TobiasLozano/ems-visualization/resultados/15W/datos_15W.xlsx

Sheet: volt_panel
id | timestamp | value
77311 | 2026-05-26 17:21 | 15.551
77312 | 2026-05-26 17:21 | 10.894
77313 | 2026-05-26 17:21 | 13.416
77314 | 2026-05-26 17:21 | 13.713
77315 | 2026-05-26 17:21 | 14.03
77316 | 2026-05-26 17:21 | 14.35
77317 | 2026-05-26 17:21 | 14.683
77318 | 2026-05-26 17:21 | 15.031
77319 | 2026-05-26 17:21 | 15.404
77320 | 2026-05-26 17:21 | 15.629
77321 | 2026-05-26 17:21 | 15.623
77322 | 2026-05-26 17:21 | 15.623
77323 | 2026-05-26 17:21 | 15.62
77324 | 2026-05-26 17:21 | 10.878
77325 | 2026-05-26 17:21 | 10.884
77326 | 2026-05-26 17:22 | 13.465
77327 | 2026-05-26 17:22 | 13.764
77328 | 2026-05-26 17:22 | 14.073
77329 | 2026-05-26 17:22 | 14.406
77330 | 2026-05-26 17:22 | 14.743
77331 | 2026-05-26 17:22 | 15.093
77332 | 2026-05-26 17:22 | 15.456
77333 | 2026-05-26 17:22 | 15.609
77334 | 2026-05-26 17:22 | 15.604
77335 | 2026-05-26 17:22 | 15.585
77336 | 2026-05-26 17:22 | 15.568
77337 | 2026-05-26 17:22 | 14.54
77338 | 2026-05-26 17:22 | 13.743
77339 | 2026-05-26 17:22 | 15.044
77340 | 2026-05-26 17:22 | 15.22
77341 | 2026-05-26 17:22 | 15.328
77342 | 2026-05-26 17:22 | 15.518
77343 | 2026-05-26 17:22 | 15.518
77344 | 2026-05-26 17:22 | 15.529
77345 | 2026-05-26 17:22 | 15.528
77346 | 2026-05-26 17:22 | 15.539
77347 | 2026-05-26 17:22 | 15.54
77348 | 2026-05-26 17:22 | 14.1
77349 | 2026-05-26 17:22 | 14.118
77350 | 2026-05-26 17:22 | 15.265
77351 | 2026-05-26 17:22 | 15.335
77352 | 2026-05-26 17:22 | 15.39
77353 | 2026-05-26 17:22 | 15.41
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
78710 | 2026-05-26 17:45 | 17.813
78711 | 2026-05-26 17:45 | 17.813
78712 | 2026-05-26 17:45 | 17.811
78713 | 2026-05-26 17:45 | 17.811
78714 | 2026-05-26 17:45 | 17.811
78715 | 2026-05-26 17:45 | 17.811
78716 | 2026-05-26 17:45 | 17.81
78717 | 2026-05-26 17:45 | 17.809
78718 | 2026-05-26 17:45 | 17.809
78719 | 2026-05-26 17:45 | 17.81
78720 | 2026-05-26 17:45 | 17.811
78721 | 2026-05-26 17:45 | 17.808
78722 | 2026-05-26 17:45 | 17.806
78723 | 2026-05-26 17:45 | 17.808
78724 | 2026-05-26 17:45 | 17.808
78725 | 2026-05-26 17:45 | 17.805
78726 | 2026-05-26 17:45 | 17.805
78727 | 2026-05-26 17:45 | 17.805
78728 | 2026-05-26 17:45 | 17.806
78729 | 2026-05-26 17:45 | 17.804
78730 | 2026-05-26 17:45 | 17.803
78731 | 2026-05-26 17:45 | 17.801
78732 | 2026-05-26 17:45 | 17.801
78733 | 2026-05-26 17:45 | 17.801
78734 | 2026-05-26 17:45 | 17.8
78735 | 2026-05-26 17:45 | 17.799
78736 | 2026-05-26 17:45 | 17.8
78737 | 2026-05-26 17:45 | 17.8

Sheet: amp_panel
id | timestamp | value
77311 | 2026-05-26 17:21 | 0.209
77312 | 2026-05-26 17:21 | 0.241
77313 | 2026-05-26 17:21 | 0.223
77314 | 2026-05-26 17:21 | 0.232
77315 | 2026-05-26 17:21 | 0.223
77316 | 2026-05-26 17:21 | 0.227
77317 | 2026-05-26 17:21 | 0.236
77318 | 2026-05-26 17:21 | 0.218
77319 | 2026-05-26 17:21 | 0.218
77320 | 2026-05-26 17:21 | 0.232
77321 | 2026-05-26 17:21 | 0.241
77322 | 2026-05-26 17:21 | 0.209
77323 | 2026-05-26 17:21 | 0.241
77324 | 2026-05-26 17:21 | 0.223
77325 | 2026-05-26 17:21 | 0.25
77326 | 2026-05-26 17:22 | 0.241
77327 | 2026-05-26 17:22 | 0.236
77328 | 2026-05-26 17:22 | 0.223
77329 | 2026-05-26 17:22 | 0.232
77330 | 2026-05-26 17:22 | 0.218
77331 | 2026-05-26 17:22 | 0.187
77332 | 2026-05-26 17:22 | 0.227
77333 | 2026-05-26 17:22 | 0.241
77334 | 2026-05-26 17:22 | 0.245
77335 | 2026-05-26 17:22 | 0.209
77336 | 2026-05-26 17:22 | 0.191
77337 | 2026-05-26 17:22 | 0.902
77338 | 2026-05-26 17:22 | 0.857
77339 | 2026-05-26 17:22 | 0.843
77340 | 2026-05-26 17:22 | 0.852
77341 | 2026-05-26 17:22 | 0.87
77342 | 2026-05-26 17:22 | 0.879
77343 | 2026-05-26 17:22 | 0.87
77344 | 2026-05-26 17:22 | 0.893
77345 | 2026-05-26 17:22 | 0.861
77346 | 2026-05-26 17:22 | 0.861
77347 | 2026-05-26 17:22 | 0.87
77348 | 2026-05-26 17:22 | 0.879
77349 | 2026-05-26 17:22 | 0.866
77350 | 2026-05-26 17:22 | 0.87
77351 | 2026-05-26 17:22 | 0.857
77352 | 2026-05-26 17:22 | 0.884
77353 | 2026-05-26 17:22 | 0.893
77354 | 2026-05-26 17:22 | 0.902
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
78729 | 2026-05-26 17:45 | 1.097
78730 | 2026-05-26 17:45 | 1.106
78731 | 2026-05-26 17:45 | 1.124
78732 | 2026-05-26 17:45 | 1.119
78733 | 2026-05-26 17:45 | 1.11
78734 | 2026-05-26 17:45 | 1.119
78735 | 2026-05-26 17:45 | 1.092
78736 | 2026-05-26 17:45 | 1.11
78737 | 2026-05-26 17:45 | 1.106

Sheet: volt_bat
id | timestamp | value
70882 | 2026-05-26 17:21 | 10.774
70883 | 2026-05-26 17:21 | 11.184
70884 | 2026-05-26 17:21 | 10.997
70885 | 2026-05-26 17:21 | 10.961
70886 | 2026-05-26 17:21 | 10.931
70887 | 2026-05-26 17:21 | 10.899
70888 | 2026-05-26 17:21 | 10.871
70889 | 2026-05-26 17:21 | 10.834
70890 | 2026-05-26 17:21 | 10.791
70891 | 2026-05-26 17:21 | 10.76
70892 | 2026-05-26 17:21 | 10.766
70893 | 2026-05-26 17:21 | 10.758
70894 | 2026-05-26 17:21 | 10.753
70895 | 2026-05-26 17:21 | 11.168
70896 | 2026-05-26 17:21 | 11.175
70897 | 2026-05-26 17:22 | 10.976
70898 | 2026-05-26 17:22 | 10.946
70899 | 2026-05-26 17:22 | 10.916
70900 | 2026-05-26 17:22 | 10.885
70901 | 2026-05-26 17:22 | 10.843
70902 | 2026-05-26 17:22 | 10.816
70903 | 2026-05-26 17:22 | 10.778
70904 | 2026-05-26 17:22 | 10.75
70905 | 2026-05-26 17:22 | 10.742
70906 | 2026-05-26 17:22 | 10.741
70907 | 2026-05-26 17:22 | 10.728
70908 | 2026-05-26 17:22 | 11.428
70909 | 2026-05-26 17:22 | 11.44
70910 | 2026-05-26 17:22 | 11.384
70911 | 2026-05-26 17:22 | 11.385
70912 | 2026-05-26 17:22 | 11.385
70913 | 2026-05-26 17:22 | 11.378
70914 | 2026-05-26 17:22 | 11.376
70915 | 2026-05-26 17:22 | 11.385
70916 | 2026-05-26 17:22 | 11.385
70917 | 2026-05-26 17:22 | 11.386
70918 | 2026-05-26 17:22 | 11.393
70919 | 2026-05-26 17:22 | 11.478
70920 | 2026-05-26 17:22 | 11.481
70921 | 2026-05-26 17:22 | 11.423
70922 | 2026-05-26 17:22 | 11.419
70923 | 2026-05-26 17:22 | 11.415
70924 | 2026-05-26 17:22 | 11.418
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
71577 | 2026-05-26 17:33 | 11.624
71578 | 2026-05-26 17:33 | 11.624
71579 | 2026-05-26 17:33 | 11.622
71580 | 2026-05-26 17:33 | 11.624
71581 | 2026-05-26 17:33 | 11.624
71582 | 2026-05-26 17:33 | 11.624
71583 | 2026-05-26 17:33 | 11.622
71584 | 2026-05-26 17:33 | 11.624
71585 | 2026-05-26 17:33 | 11.624
71586 | 2026-05-26 17:33 | 11.624
71587 | 2026-05-26 17:33 | 11.625
71588 | 2026-05-26 17:33 | 11.625
71589 | 2026-05-26 17:33 | 11.625
71590 | 2026-05-26 17:33 | 11.624
71591 | 2026-05-26 17:33 | 11.625
71592 | 2026-05-26 17:33 | 11.624
71593 | 2026-05-26 17:33 | 11.624
71594 | 2026-05-26 17:33 | 11.625
71595 | 2026-05-26 17:33 | 11.628
71596 | 2026-05-26 17:33 | 11.625
71597 | 2026-05-26 17:33 | 11.626
71598 | 2026-05-26 17:33 | 11.625
71599 | 2026-05-26 17:33 | 11.625
71600 | 2026-05-26 17:33 | 11.625
71601 | 2026-05-26 17:33 | 11.626
71602 | 2026-05-26 17:33 | 11.626
71603 | 2026-05-26 17:33 | 11.625
71604 | 2026-05-26 17:33 | 11.626
71605 | 2026-05-26 17:33 | 11.626
71606 | 2026-05-26 17:33 | 11.625
71607 | 2026-05-26 17:33 | 11.626
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
