TobiasLozano/ems-visualization/resultados/20W/datos_20W.xlsx

Sheet: volt_panel
id | timestamp | value
69041 | 2026-05-25 18:42 | 17.463
69042 | 2026-05-25 18:42 | 13.82
69043 | 2026-05-25 18:42 | 17.503
69044 | 2026-05-25 18:42 | 17.528
69045 | 2026-05-25 18:42 | 17.526
69046 | 2026-05-25 18:42 | 17.686
69047 | 2026-05-25 18:42 | 17.694
69048 | 2026-05-25 18:42 | 17.744
69049 | 2026-05-25 18:42 | 17.744
69050 | 2026-05-25 18:42 | 17.76
69051 | 2026-05-25 18:42 | 17.815
69052 | 2026-05-25 18:42 | 18.006
69053 | 2026-05-25 18:42 | 18.193
69054 | 2026-05-25 18:42 | 18.378
69055 | 2026-05-25 18:42 | 18.489
69056 | 2026-05-25 18:42 | 11.73
69057 | 2026-05-25 18:42 | 17.484
69058 | 2026-05-25 18:42 | 17.643
69059 | 2026-05-25 18:42 | 17.638
69060 | 2026-05-25 18:42 | 17.663
69061 | 2026-05-25 18:42 | 17.68
69062 | 2026-05-25 18:42 | 17.726
69063 | 2026-05-25 18:42 | 17.725
69064 | 2026-05-25 18:42 | 17.718
69065 | 2026-05-25 18:43 | 17.836
69066 | 2026-05-25 18:43 | 18.033
69067 | 2026-05-25 18:43 | 18.21
69068 | 2026-05-25 18:43 | 18.405
69069 | 2026-05-25 18:43 | 17.539
69070 | 2026-05-25 18:43 | 13.158
69071 | 2026-05-25 18:43 | 12.514
69072 | 2026-05-25 18:43 | 17.534
69073 | 2026-05-25 18:43 | 17.625
69074 | 2026-05-25 18:43 | 17.694
69075 | 2026-05-25 18:43 | 17.666
69076 | 2026-05-25 18:43 | 17.669
69077 | 2026-05-25 18:43 | 17.698
69078 | 2026-05-25 18:43 | 17.713
69079 | 2026-05-25 18:43 | 17.735
69080 | 2026-05-25 18:43 | 17.804
69081 | 2026-05-25 18:43 | 18.016
69082 | 2026-05-25 18:43 | 18.19
69083 | 2026-05-25 18:43 | 18.4
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
71812 | 2026-05-25 19:28 | 9.468
71813 | 2026-05-25 19:28 | 9.444
71814 | 2026-05-25 19:28 | 9.473
71815 | 2026-05-25 19:28 | 9.52
71816 | 2026-05-25 19:28 | 9.521
71817 | 2026-05-25 19:28 | 9.528
71818 | 2026-05-25 19:28 | 9.526
71819 | 2026-05-25 19:28 | 9.525
71820 | 2026-05-25 19:28 | 9.523

Sheet: amp_panel
id | timestamp | value
69041 | 2026-05-25 18:42 | 1.078
69042 | 2026-05-25 18:42 | 1.178
69043 | 2026-05-25 18:42 | 1.051
69044 | 2026-05-25 18:42 | 1.038
69045 | 2026-05-25 18:42 | 1.06
69046 | 2026-05-25 18:42 | 1.015
69047 | 2026-05-25 18:42 | 1.011
69048 | 2026-05-25 18:42 | 0.988
69049 | 2026-05-25 18:42 | 0.965
69050 | 2026-05-25 18:42 | 0.979
69051 | 2026-05-25 18:42 | 0.938
69052 | 2026-05-25 18:42 | 0.861
69053 | 2026-05-25 18:42 | 0.734
69054 | 2026-05-25 18:42 | 0.608
69055 | 2026-05-25 18:42 | 0.544
69056 | 2026-05-25 18:42 | 1.133
69057 | 2026-05-25 18:42 | 1.056
69058 | 2026-05-25 18:42 | 1.002
69059 | 2026-05-25 18:42 | 1.029
69060 | 2026-05-25 18:42 | 0.979
69061 | 2026-05-25 18:42 | 0.965
69062 | 2026-05-25 18:42 | 1.011
69063 | 2026-05-25 18:42 | 0.992
69064 | 2026-05-25 18:42 | 0.974
69065 | 2026-05-25 18:43 | 0.92
69066 | 2026-05-25 18:43 | 0.839
69067 | 2026-05-25 18:43 | 0.707
69068 | 2026-05-25 18:43 | 0.594
69069 | 2026-05-25 18:43 | 1.078
69070 | 2026-05-25 18:43 | 1.269
69071 | 2026-05-25 18:43 | 1.232
69072 | 2026-05-25 18:43 | 1.056
69073 | 2026-05-25 18:43 | 1.002
69074 | 2026-05-25 18:43 | 1.051
69075 | 2026-05-25 18:43 | 1.02
69076 | 2026-05-25 18:43 | 0.988
69077 | 2026-05-25 18:43 | 0.997
69078 | 2026-05-25 18:43 | 0.974
69079 | 2026-05-25 18:43 | 0.979
69080 | 2026-05-25 18:43 | 0.925
69081 | 2026-05-25 18:43 | 0.848
69082 | 2026-05-25 18:43 | 0.734
69083 | 2026-05-25 18:43 | 0.603
69084 | 2026-05-25 18:43 | 0.526
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
69819 | 2026-05-25 18:55 | 1.164
69820 | 2026-05-25 18:55 | 1.178
69821 | 2026-05-25 18:55 | 1.174
69822 | 2026-05-25 18:55 | 1.178
69823 | 2026-05-25 18:55 | 1.178
69824 | 2026-05-25 18:55 | 1.187
69825 | 2026-05-25 18:55 | 1.174
69826 | 2026-05-25 18:55 | 1.192
69827 | 2026-05-25 18:55 | 1.16
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
