TobiasLozano/ems-visualization/resultados/Carga_Bateria/datos_Carga_Bateria.xlsx

Sheet: volt_panel
id | timestamp | value
28054 | 2026-05-13 15:54 | 0
28055 | 2026-05-13 15:54 | 0
28056 | 2026-05-13 15:54 | 0
28057 | 2026-05-13 15:54 | 0
28058 | 2026-05-13 15:54 | 0
28059 | 2026-05-13 15:54 | 0
28060 | 2026-05-13 15:54 | 0
28061 | 2026-05-13 15:54 | 0
28062 | 2026-05-13 15:54 | 0
28063 | 2026-05-13 15:54 | 0
28064 | 2026-05-13 15:54 | 0
28065 | 2026-05-13 15:54 | 0
28066 | 2026-05-13 15:54 | 0
28067 | 2026-05-13 15:54 | 0
28068 | 2026-05-13 15:54 | 0
28069 | 2026-05-13 15:54 | 0
28070 | 2026-05-13 15:54 | 0
28071 | 2026-05-13 15:54 | 0
28072 | 2026-05-13 15:54 | 0
28073 | 2026-05-13 15:54 | 0
28074 | 2026-05-13 15:54 | 0
28075 | 2026-05-13 15:54 | 0
28076 | 2026-05-13 15:54 | 0
28077 | 2026-05-13 15:54 | 0
28078 | 2026-05-13 15:54 | 0
28079 | 2026-05-13 15:54 | 0
28080 | 2026-05-13 15:54 | 0
28081 | 2026-05-13 15:54 | 0
28082 | 2026-05-13 15:54 | 0
28083 | 2026-05-13 15:54 | 0
28084 | 2026-05-13 15:54 | 0
28085 | 2026-05-13 15:54 | 0
28086 | 2026-05-13 15:54 | 0
28087 | 2026-05-13 15:54 | 0
28088 | 2026-05-13 15:54 | 0
28089 | 2026-05-13 15:54 | 0
28090 | 2026-05-13 15:54 | 0
28091 | 2026-05-13 15:54 | 0
28092 | 2026-05-13 15:54 | 0
28093 | 2026-05-13 15:54 | 0
28094 | 2026-05-13 15:54 | 0
28095 | 2026-05-13 15:54 | 0
28096 | 2026-05-13 15:54 | 0
28097 | 2026-05-13 15:54 | 0
28098 | 2026-05-13 15:54 | 0
28099 | 2026-05-13 15:54 | 0
28100 | 2026-05-13 15:54 | 0
28101 | 2026-05-13 15:55 | 0
28102 | 2026-05-13 15:55 | 0
28103 | 2026-05-13 15:55 | 0
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
29764 | 2026-05-13 16:00 | 17.3
29765 | 2026-05-13 16:00 | 17.3
29766 | 2026-05-13 16:00 | 17.3
29767 | 2026-05-13 16:00 | 17.3
29768 | 2026-05-13 16:00 | 17.3
29769 | 2026-05-13 16:00 | 17.3
29770 | 2026-05-13 16:00 | 17.3
29771 | 2026-05-13 16:00 | 17.3
29772 | 2026-05-13 16:00 | 17.3
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
