TobiasLozano/ems-visualization/(commit log)

2026-08-28 docs: add full docusaurus documentation and DNDA assets
    - Complete Docusaurus documentation (Firmware, Web App, Docker, Testing)
    - Rewrite README.md to reflect Web Serial API architecture
    - Generate consolidated PDF and TXT files for DNDA software registration
    - Add downloadable firmware source code in docs
    - Add .env.example template
    - Tone changes to third person across all docs
    [datos_15W.xlsx, datos_20W.xlsx, datos_25W.xlsx, datos_Carga_Bateria.xlsx, datos_Termica.xlsx]
2026-10-14 docs: reestructuracion del manual de usuario, consolidacion de referencia tecnica y actualizacion de imagenes Docker
    - Consolidacion del Manual de Usuario en 6 capitulos estandarizados.
    - Automatizacion de compilacion para exportacion a PDF sin redundancias de encabezados ni saltos en blanco.
    - Eliminacion de secciones redundantes (7, 8 y 9) en los Anexos de Referencia Tecnica.
    - Reemplazo de la Figura 3.1 por el diagrama topologico en bloques de la microrred DC.
    - Ajuste del Anexo 6 de arquitectura de software y modelo PostgreSQL optimizado para Grafana.
    - Actualizacion completa del README principal con trama serial real, tablas indexadas y enlaces de produccion.
    - Despliegue de imagenes de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
2026-10-15 docs: actualizar enlaces https de produccion y referenciar archivos de firmware
2026-10-15 chore(grafana): limpiar lista de links en dashboard JSON
