TobiasLozano/ems-visualization/(notices)

Notices in the files:
README.md:
License: Academic
